jokn999/diy-spin-coater/CAD_full_assembly.step

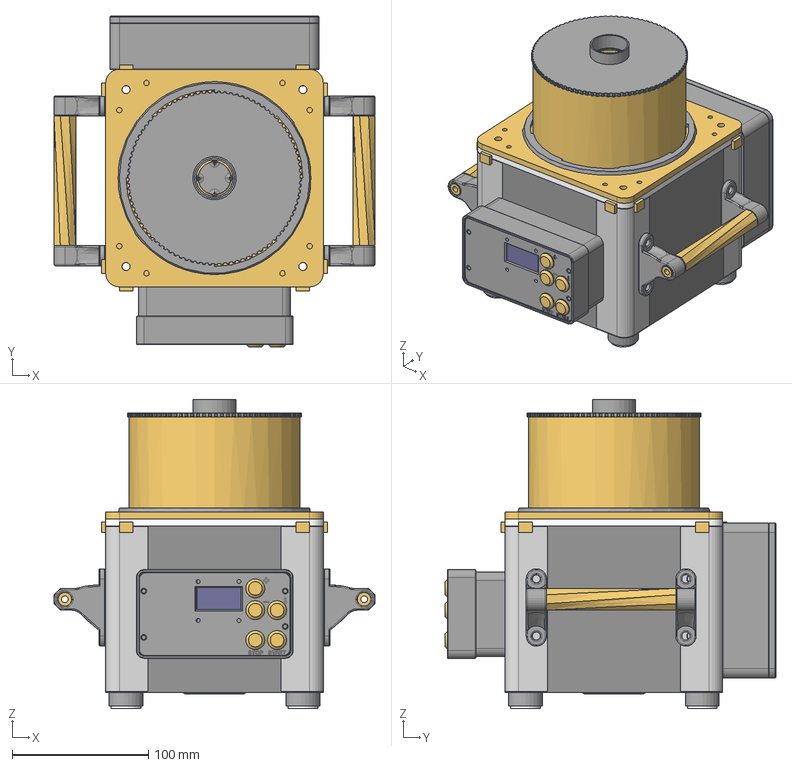
[picture p1: CAD file, 2026-11-02]
CAD_full_assembly.step
236.0 x 243.0 x 227.4 mm
M6x30 x 16
M4x3.2 x 8
23HS40-5004D-E1K-1M5_1
闭环电机压线块
reservoir
reservoir_lock
common_plate
reservoir_lid
common_plate_template
universal_chuck
1inch_chuck
driver_housing_lid
CUZHU-M3X5-3_3 x 3
GBT9074_1_M3X4_4
GBT9074_1_M3X4_4_1
GBT9074_4_M3X6_3 x 3
DOWN_6
15EDGRC-3_81-2PIN_3
15EDGRC-3_81-6PIN_3 x 3
EPS106A-8P
LHY3302-3-2PIN_3
PCB_10
SS_4
CL57Y-SHELL
s 6-pin x 3
s 2-pin
driver_housing_1
ESP32
driver_terminals
control_unit_housing_lid
i2c_level_converter
PIN HEADER MALE 2.54MM P4
PIN HEADER FAMALE 2.54MM P4
4 lü Lehim v2
button x 5
control_unit_protective_cover
control_unit_housing
handle_mount x 2
handle x 2
foot x 4
felt_pad x 4
nut_guide
casing
casing_alt
casing_alt_strut
